Sermelyan/RFIDreader/README.md

# RFIDreader
Stm32+mfrc522
Ссылка на папку с документацией - https://drive.google.com/open?id=1Ol4aUnXzzG5ZaBnfFhphDsJd5Xnp3BTj
