Sermelyan/RFIDreader/Documentation/Э1C.jpg

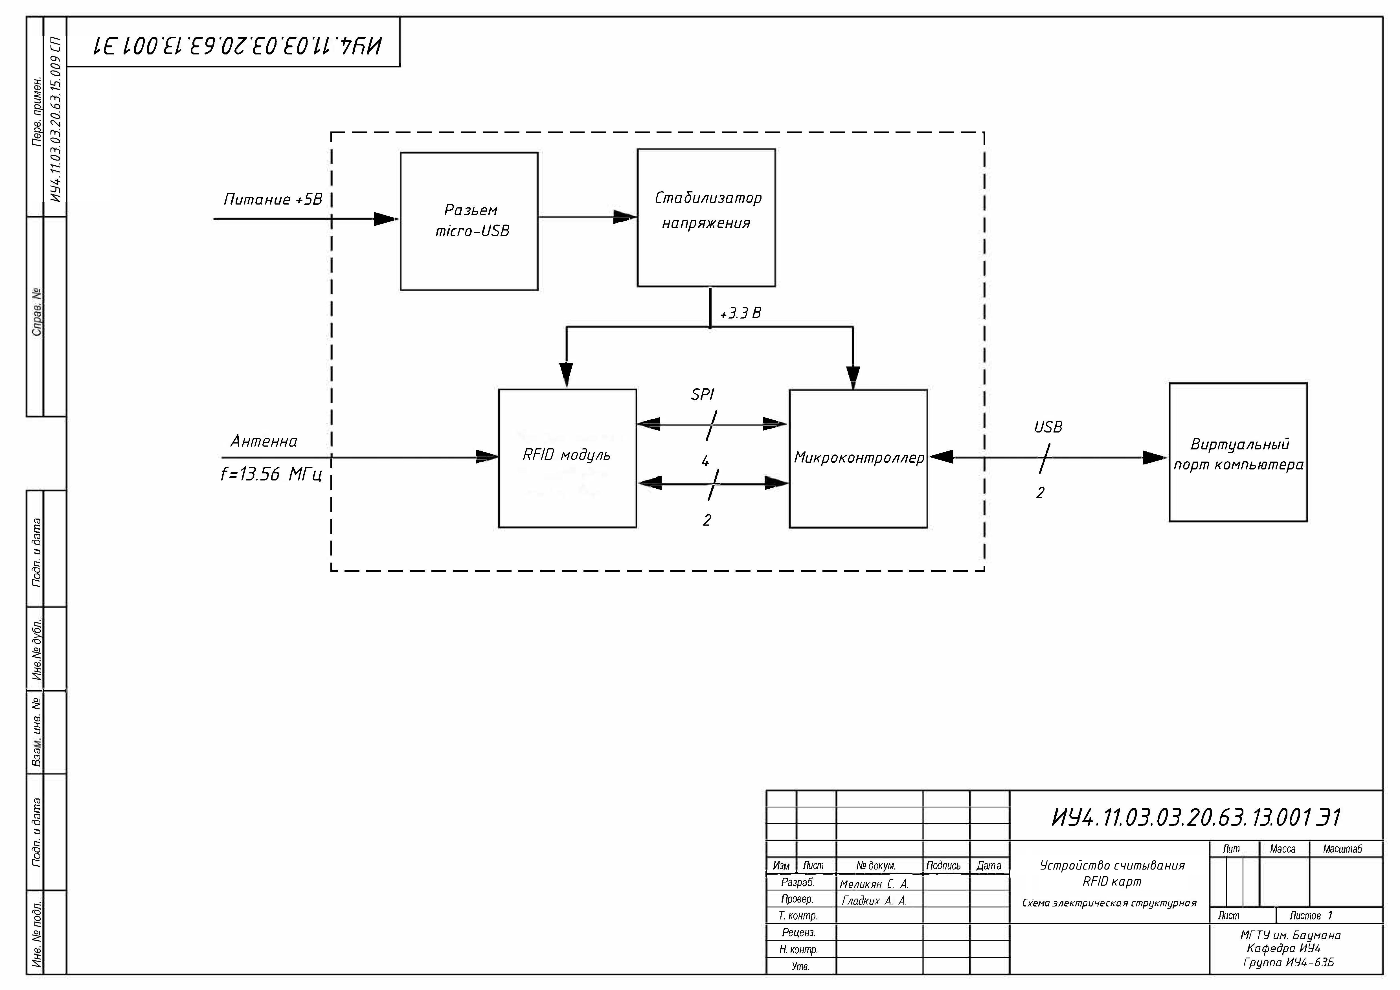
Documentation/Э1C.jpg
