Sermelyan/RFIDreader/(list of files, cad)

Other CAD files:
Hardware/3D/Board.iam
Hardware/3D/C1.iam
Hardware/3D/C10.iam
Hardware/3D/C11.iam
Hardware/3D/C12.iam
Hardware/3D/C2.iam
Hardware/3D/C3.iam
Hardware/3D/C4.iam
Hardware/3D/C5.iam
Hardware/3D/C6.iam
Hardware/3D/C7.iam
Hardware/3D/C8.iam
Hardware/3D/C9.iam
Hardware/3D/D1.iam
Hardware/3D/DA1.iam
Hardware/3D/Open CASCADE STEP translator 6.8 1.1.1.ipt
Hardware/3D/PLS-1.iam
Hardware/3D/PLS-1_1.iam
Hardware/3D/PLS-4.iam
Hardware/3D/PLS-8.iam
Hardware/3D/R1.iam
Hardware/3D/R2.iam
Hardware/3D/R3.iam
Hardware/3D/R4.iam
Hardware/3D/R5.iam
Hardware/3D/R6.iam
Hardware/3D/R7.iam
Hardware/3D/R8.iam
Hardware/3D/R9.iam
Hardware/3D/SB1.iam
Hardware/3D/SOT-223.ipt
Hardware/3D/STM32F334.ipt
Hardware/3D/SW3dPS-0805_SMD_Capacitor.ipt
Hardware/3D/User_Library-AVX_D_CASE.ipt
Hardware/3D/User_Library-CapAluRadial_D80H115.iam
Hardware/3D/User_Library-CapAluRadial_D80H115_can.ipt
Hardware/3D/User_Library-CapAluRadial_D80H115_lead.ipt
Hardware/3D/User_Library-CapAluRadial_D80H115_rubber_pad.ipt
Hardware/3D/User_Library-CapAluRadial_D80H115_shell_and_minus.ipt
Hardware/3D/User_Library-CapAluRadial_D80H115_shell_and_minus_2.ipt
Hardware/3D/User_Library-Diode_Molded_BodyDIOM5025X231N.ipt
Hardware/3D/User_Library-FYLS-1206.ipt
Hardware/3D/User_Library-PTS645SL43SMTR92-LFS.iam
Hardware/3D/User_Library-PTS645SL43SMTR92-LFS_1.ipt
Hardware/3D/User_Library-PTS645SL43SMTR92-LFS_10.ipt
Hardware/3D/User_Library-PTS645SL43SMTR92-LFS_11.ipt
Hardware/3D/User_Library-PTS645SL43SMTR92-LFS_2.ipt
Hardware/3D/User_Library-PTS645SL43SMTR92-LFS_3.ipt
Hardware/3D/User_Library-PTS645SL43SMTR92-LFS_4.ipt
Hardware/3D/User_Library-PTS645SL43SMTR92-LFS_5.ipt
Hardware/3D/User_Library-PTS645SL43SMTR92-LFS_6.ipt
Hardware/3D/User_Library-PTS645SL43SMTR92-LFS_7.ipt
Hardware/3D/User_Library-PTS645SL43SMTR92-LFS_8.ipt
Hardware/3D/User_Library-PTS645SL43SMTR92-LFS_9.ipt
Hardware/3D/User_Library-SMU4.iam
Hardware/3D/User_Library-SMU4_SM4_BASE_2_Valor_predeterminado.ipt
Hardware/3D/User_Library-SMU4_SMU4_BASE_Valor_predeterminado.ipt
Hardware/3D/User_Library-micro_usb_SMD.ipt
Hardware/3D/VD1.iam
Hardware/3D/VD2.iam
Hardware/3D/VD3.iam
Hardware/3D/VD3.newVer.iam
Hardware/3D/X1.iam
Hardware/3D/X2.iam
Hardware/3D/X3.iam
Hardware/3D/ZQ1.iam
Hardware/3D/chip_0805_r.ipt
Hardware/3D/îñíîâàíèå.ipt
Hardware/3D/îñíîâàíèå_1.ipt
Hardware/3D/ïðÿìîé_øòûðü.ipt
Hardware/3D/ïðÿìîé_øòûðü_1.ipt
Hardware/3D/ИУ4.11.03.03.20.63.13.iam
