Sermelyan/RFIDreader/Documentation/ИУ4.11.03.03.20.63.13.003 Э3.pdf

2 DA1

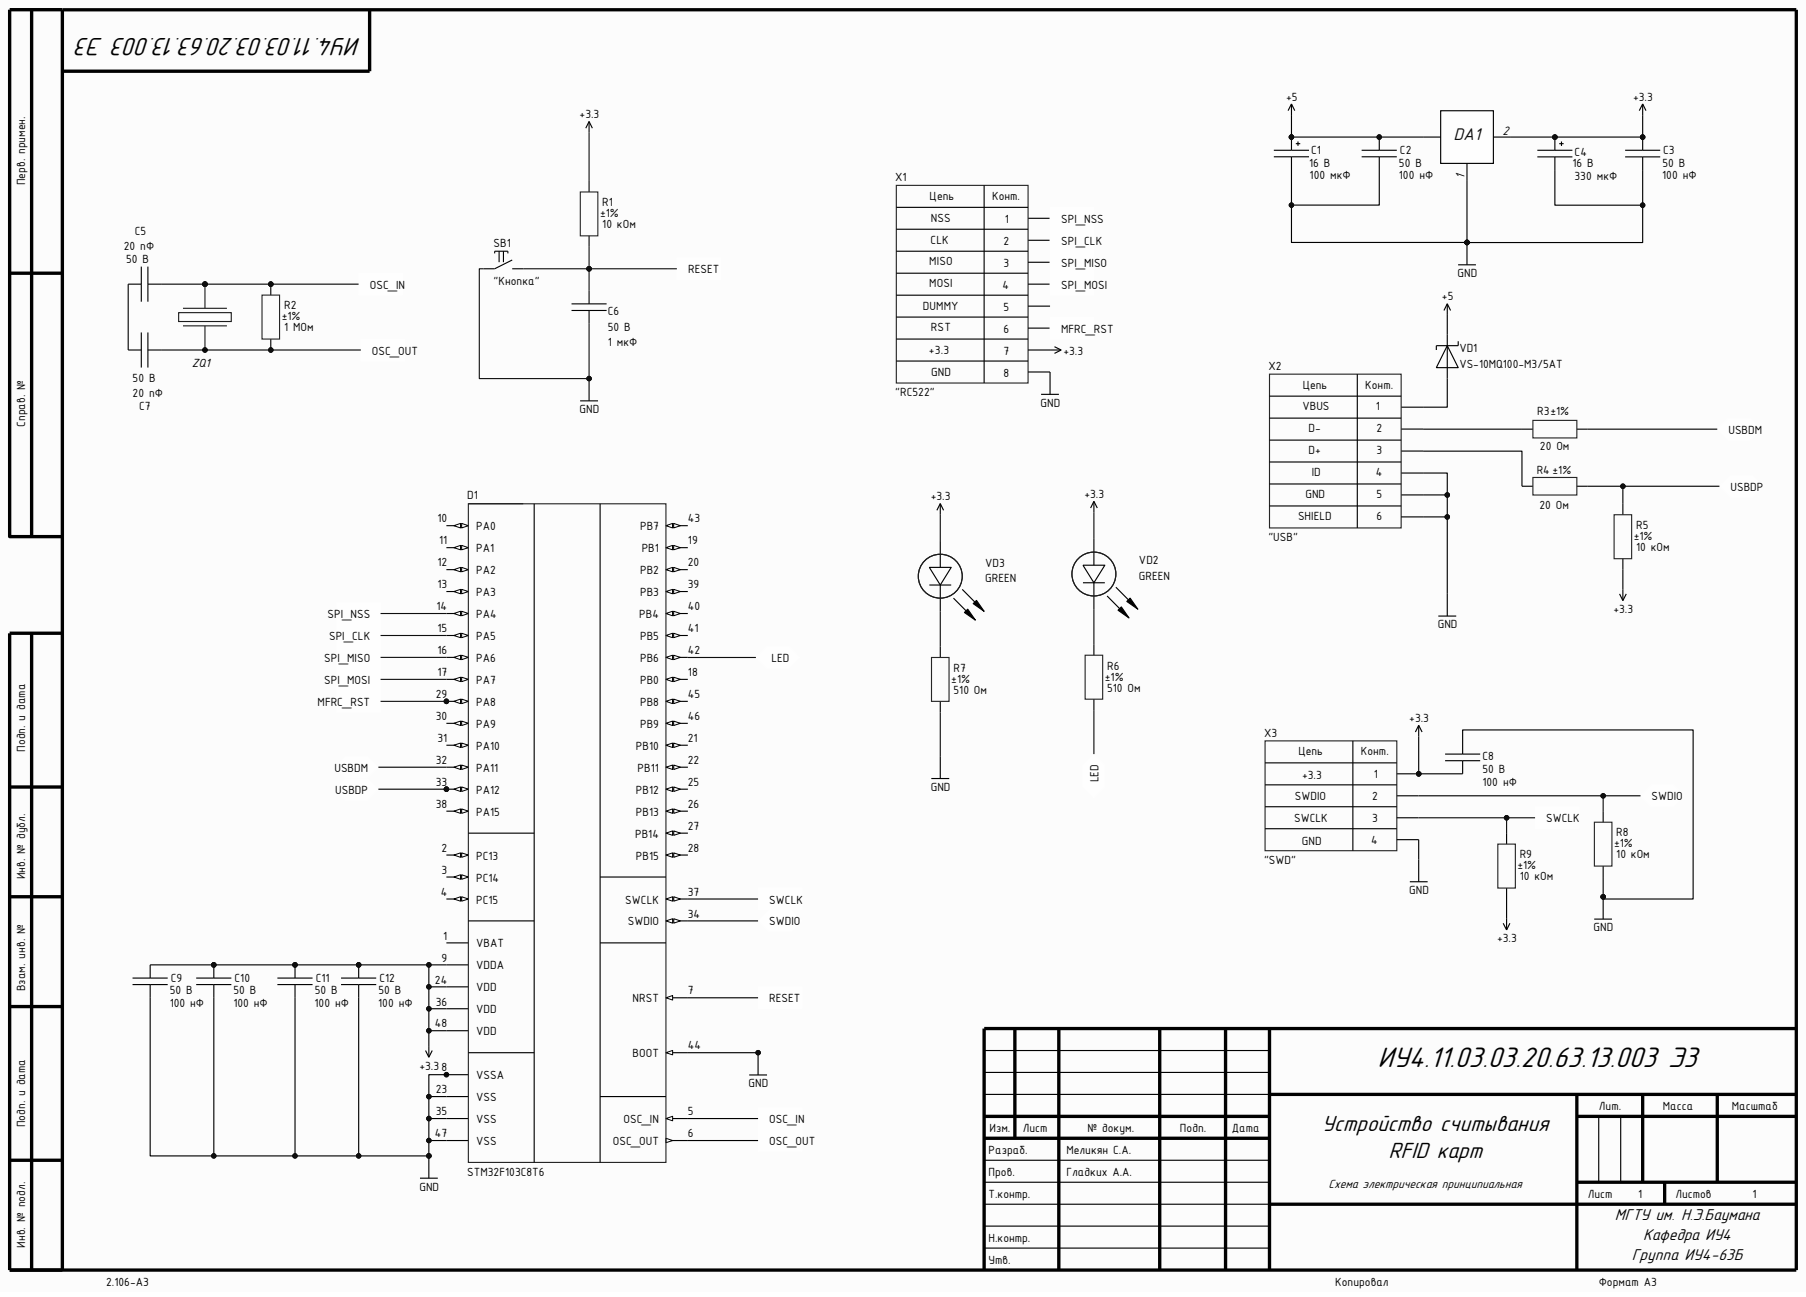
[picture p26: page 1]

Инв. № подл. Инв. № дубл. Подп. и дата Взам. инв. № Подп. и дата Перв. примен. Справ. №

Цепь | Конт.
NSS | 1

CLK | 2

MISO | 3

MOSI | 4

DUMMY | 5

RST | 6

GND | 8

VBUS | 1

D- | 2
D+ | 3 | 20 Ом R4 ±1%

GND | 5

SHIELD | 6

SWDIO | 2

SWCLK | 3

GND | 4

Изм. | Лист | № докум. | Подп. | Дата

Разраб. | | Меликян С.А.

Пров. | | Гладких А.А.

Т.контр. | | | | | Лист 1 | Листов 1

z £ xª£¤ «§  Ãðóïïà ÈÓ4-63Á

Н.контр.

Утв.
