Sermelyan/RFIDreader/Documentation/ИУ4.11.03.03.20.63.13.002 ПД1.pdf

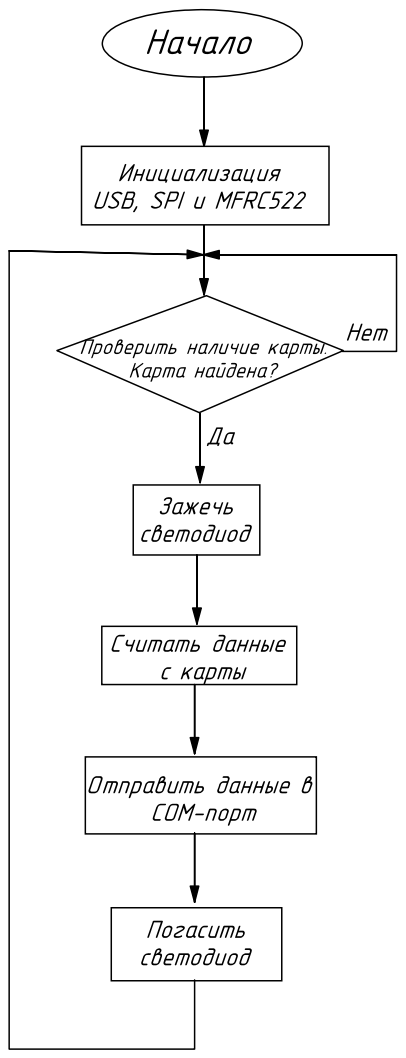
[picture p27: page 1]
