Sermelyan/RFIDreader/Documentation/ИУ4.11.03.03.20.63.13.004 ПЭЗ.pdf

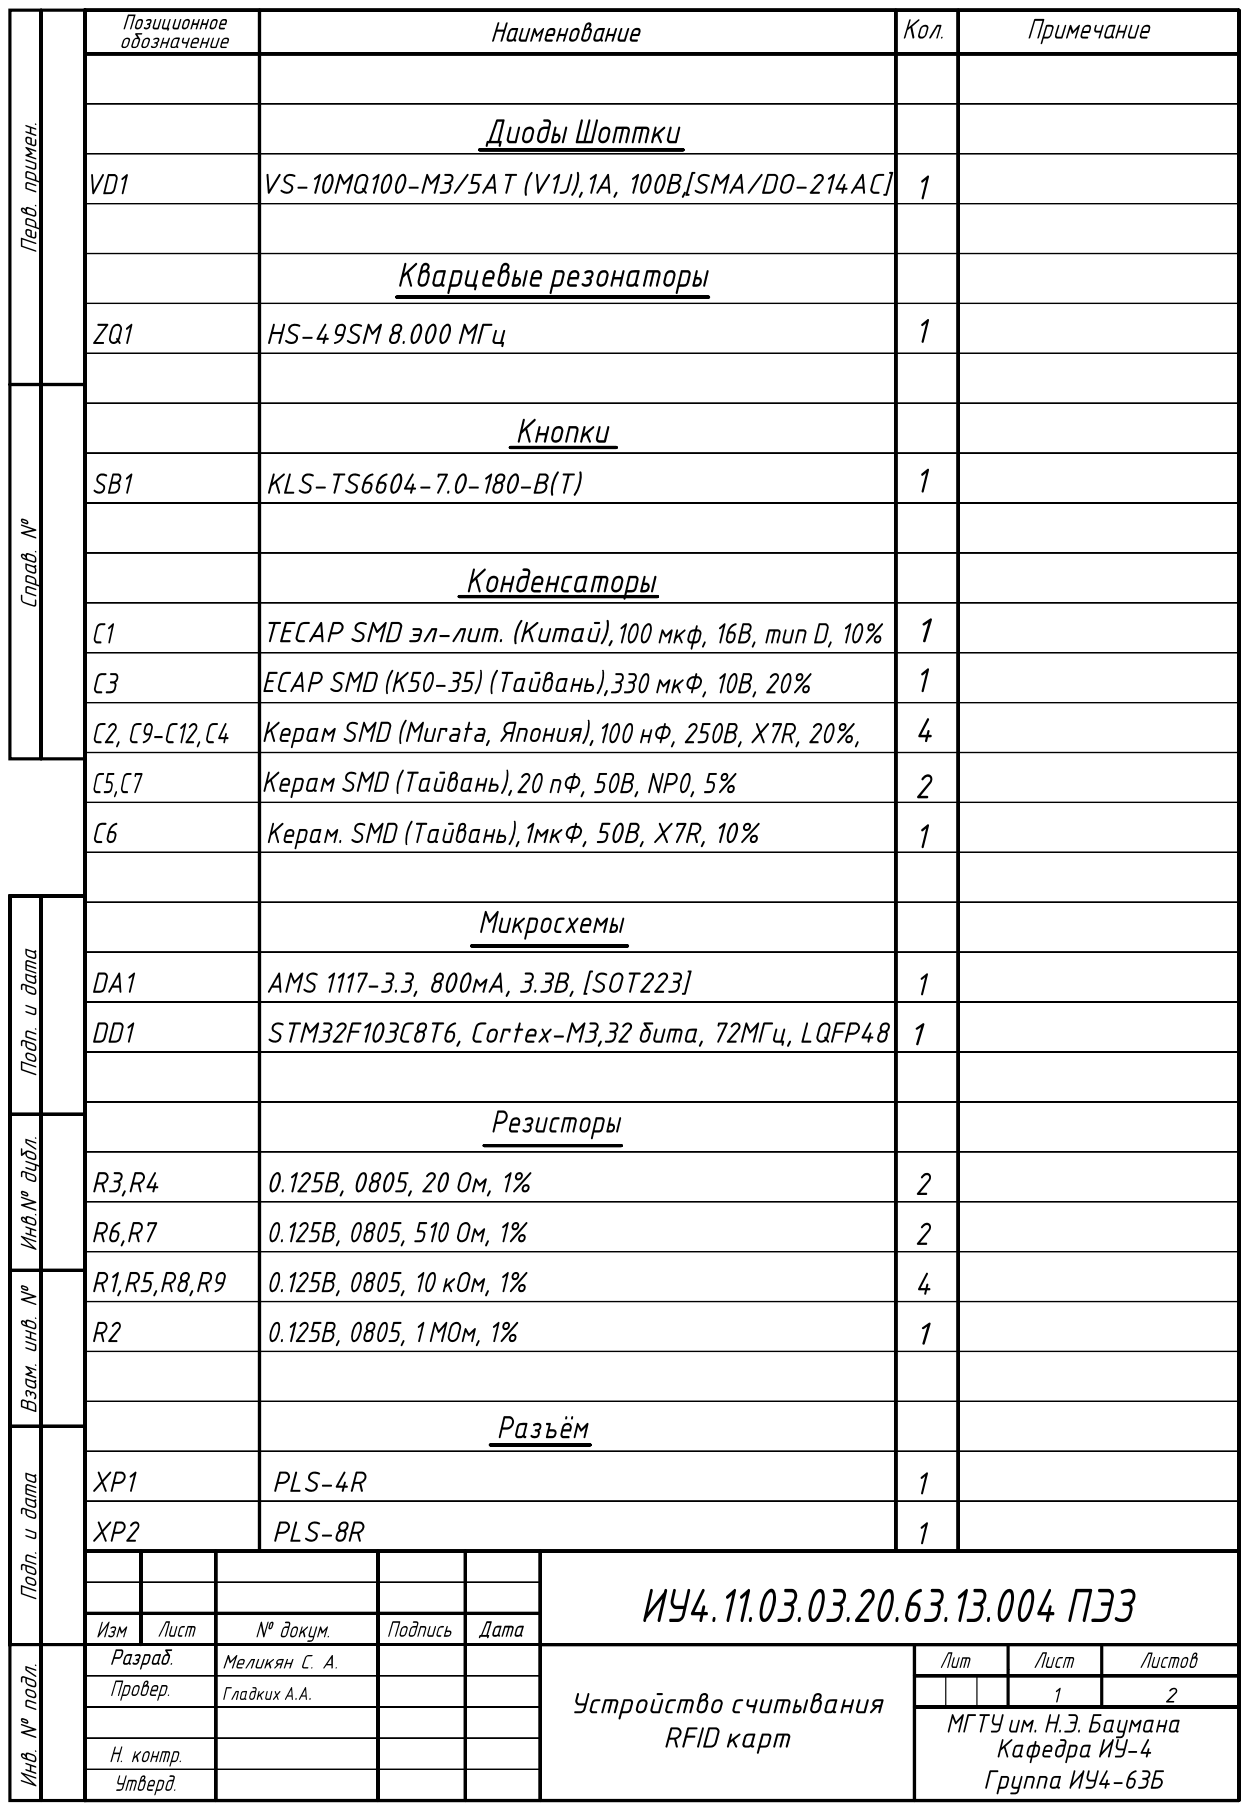
[picture p28: page 1]

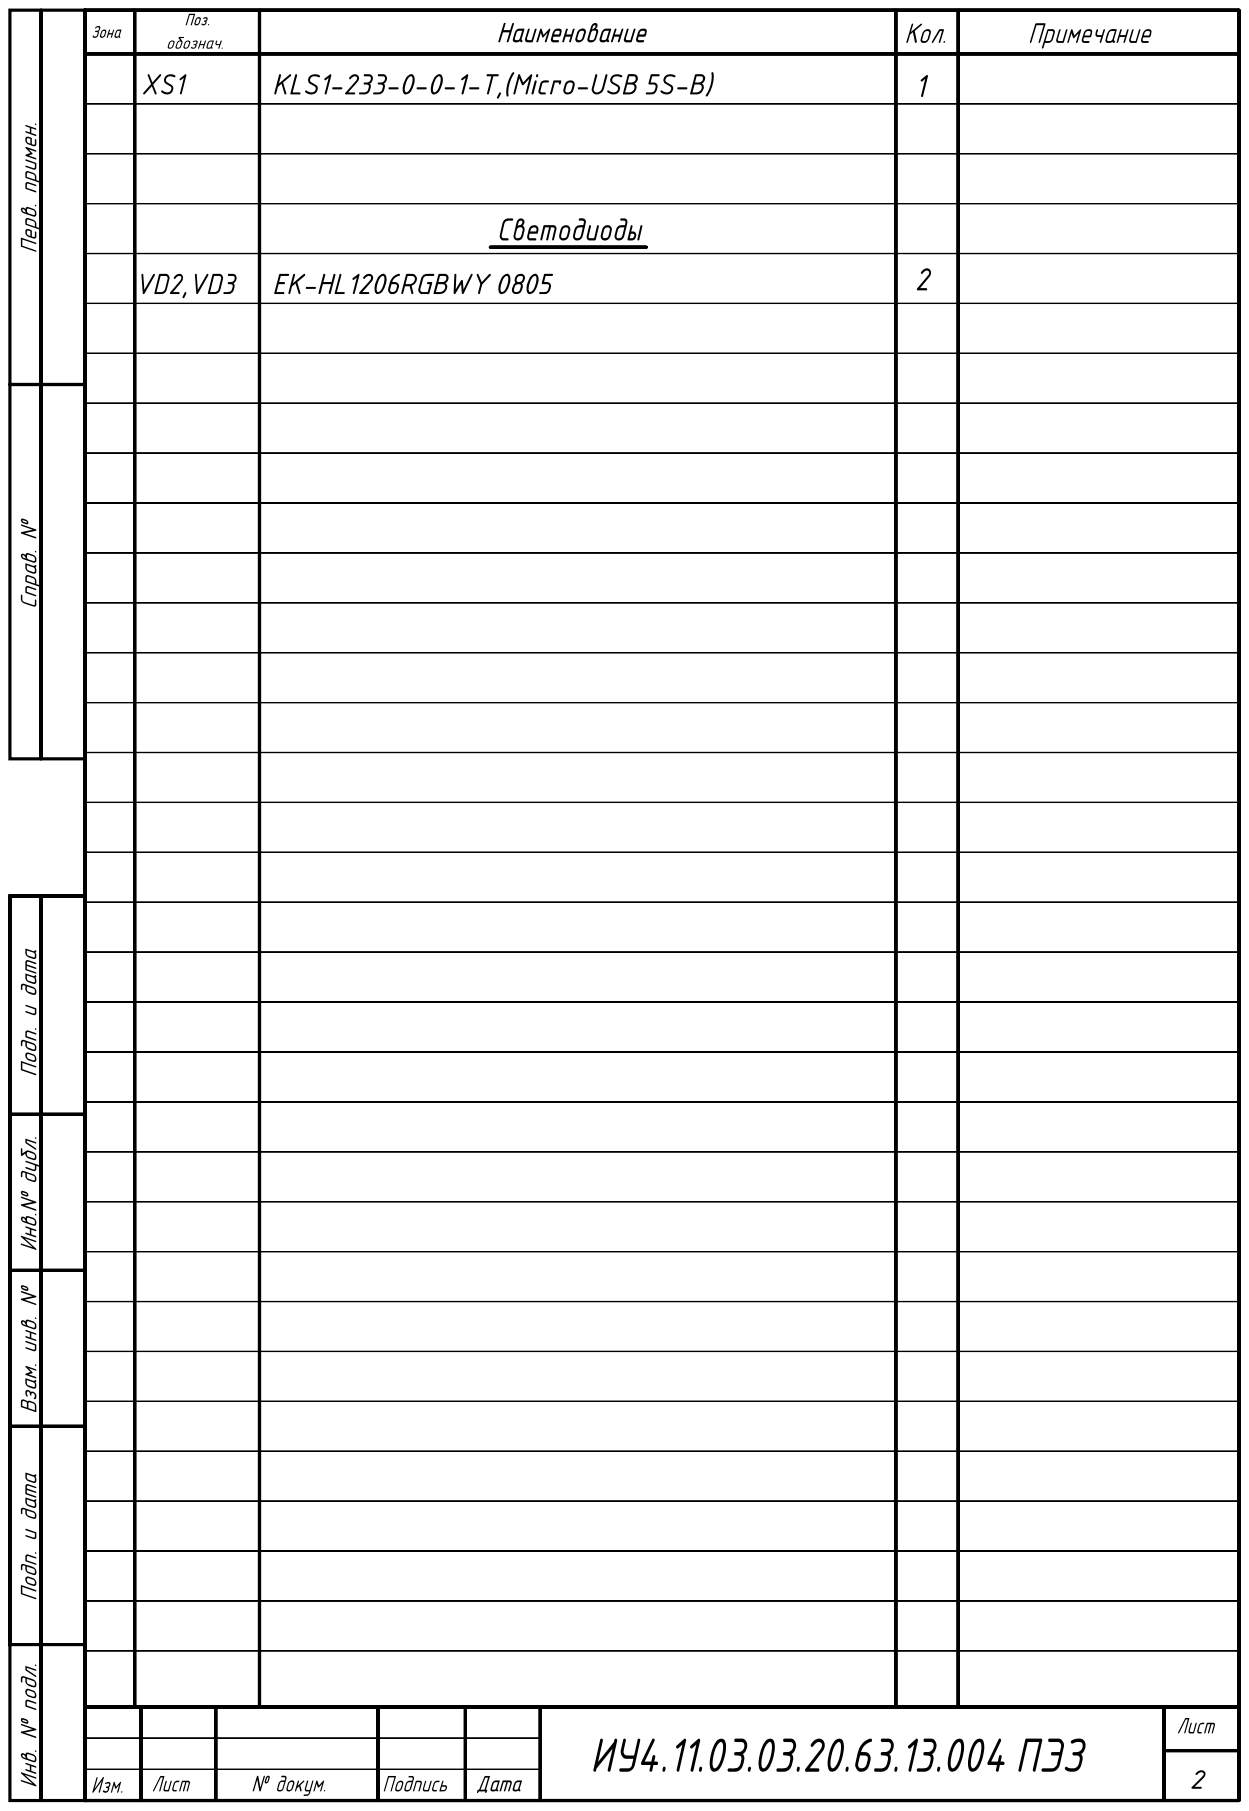
[picture p29: page 2]
