Sermelyan/RFIDreader/Documentation/ИУ4.11.03.03.20.63.13.007 Э1.pdf

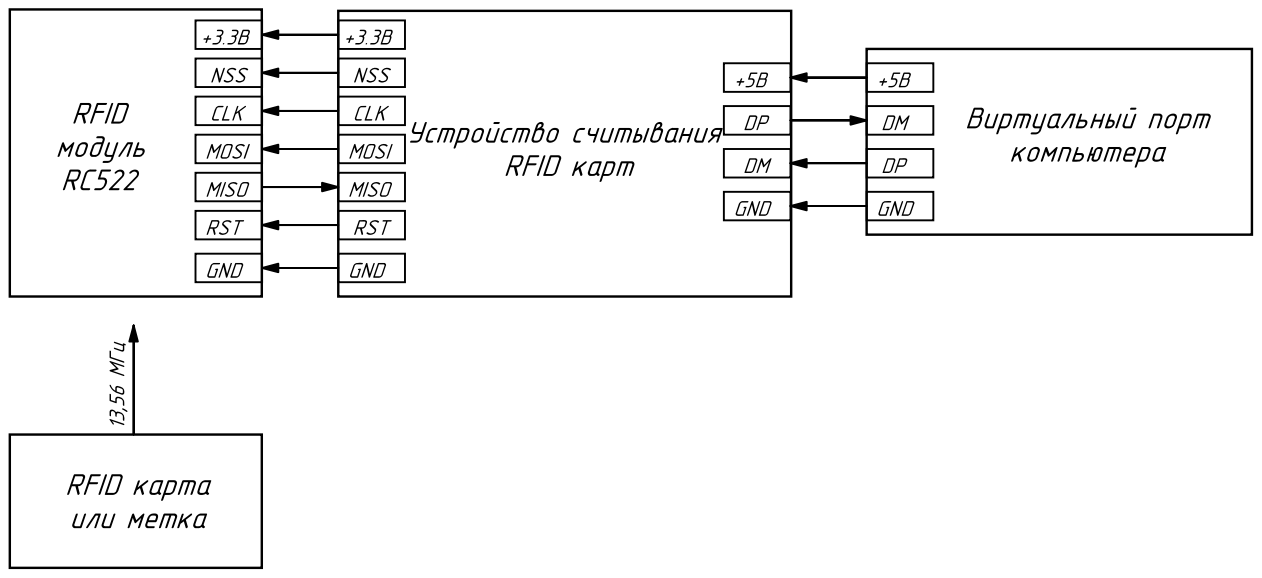
[picture p30: page 1]
