Sermelyan/RFIDreader/Documentation/ИУ4.11.03.03.20.63.13.009 СП1.pdf

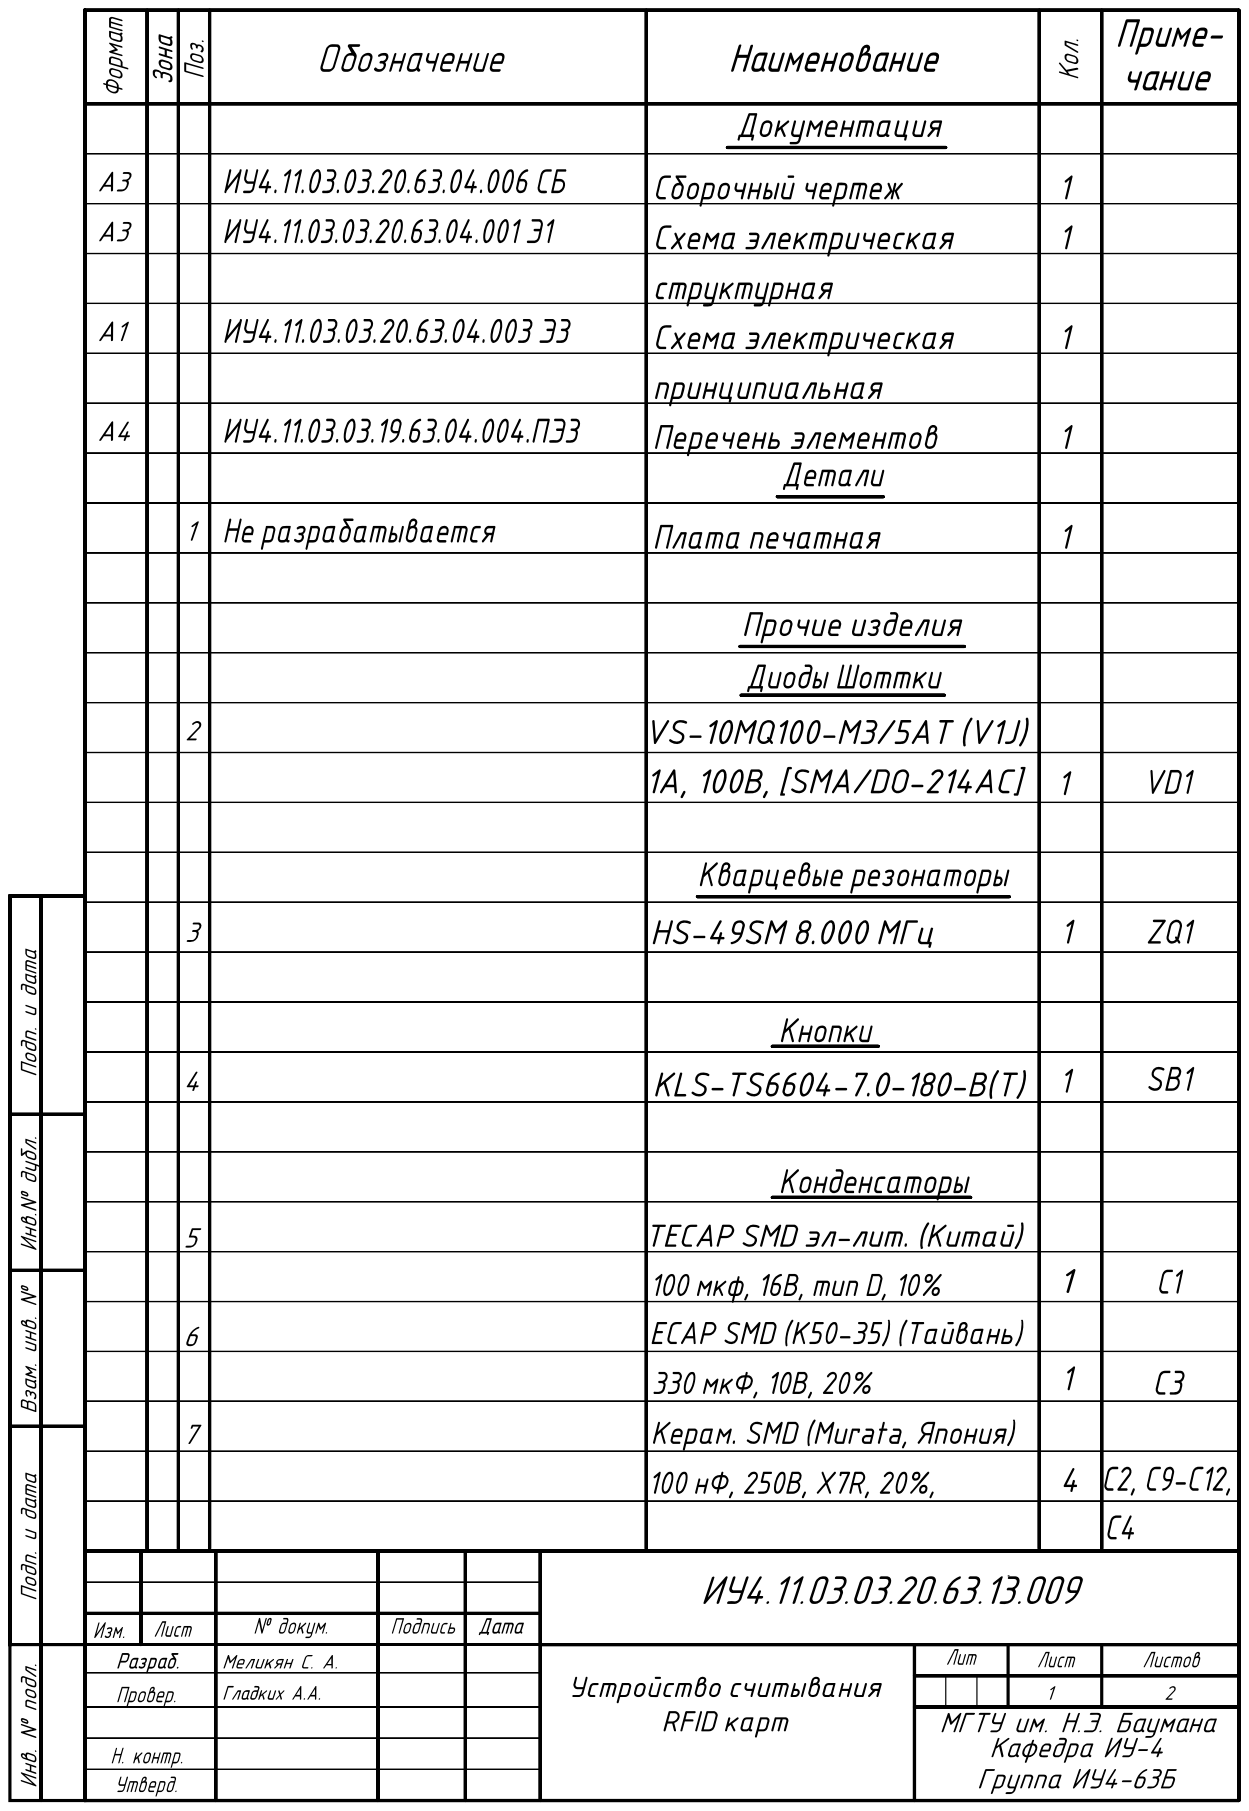
[picture p31: page 1]
