Sermelyan/RFIDreader/Documentation/ИУ4.11.03.03.20.63.13.009 СП2.pdf

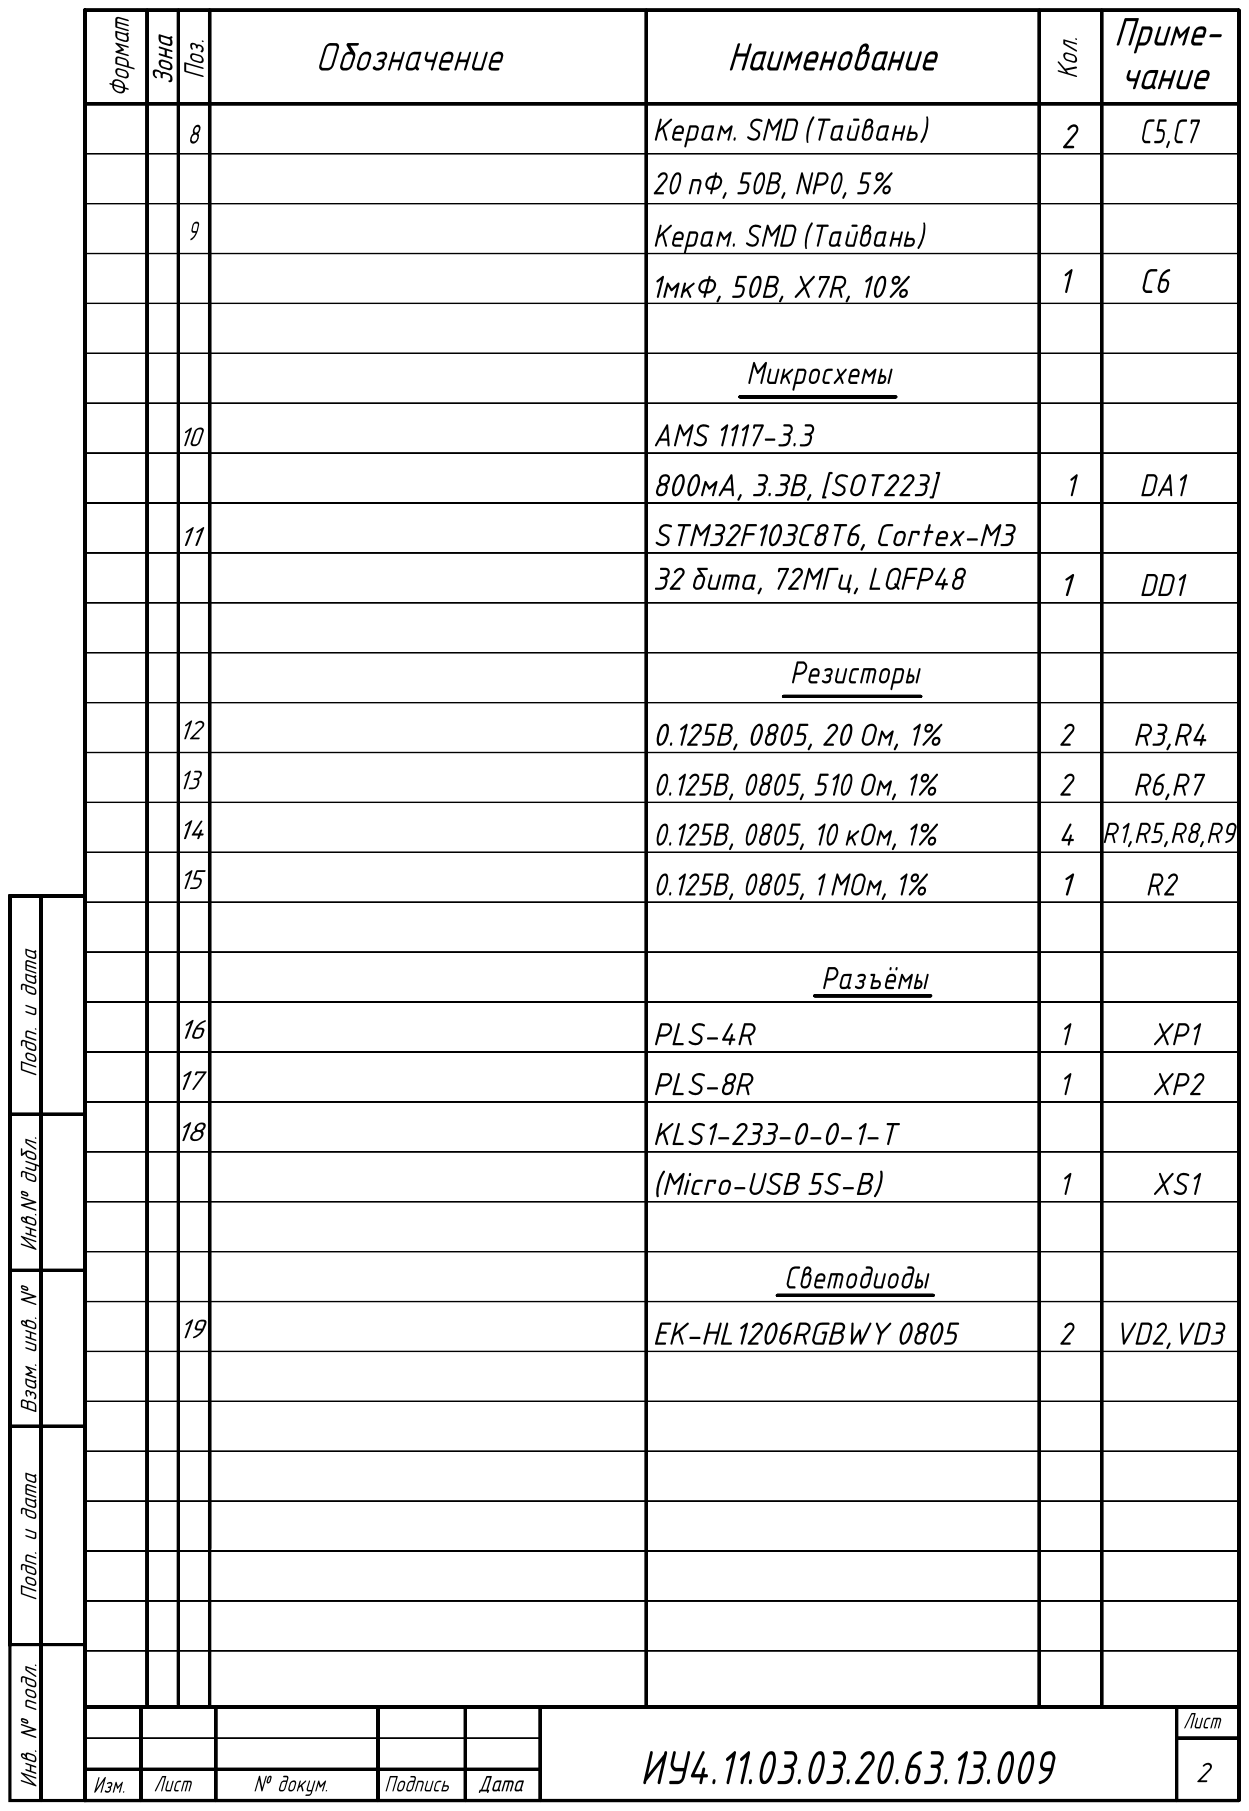
[picture p32: page 1]
