Sermelyan/RFIDreader/(list of files, drawings)

Other design files:
Hardware/ИУ4.11.03.03.20.63.13.PcbDoc
Hardware/ИУ4.11.03.03.20.63.13.PrjPcb
Hardware/ИУ4.11.03.03.20.63.13.SchDoc
