Sermelyan/RFIDreader/Software/Core/Src/main.c

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
/* Includes ------------------------------------------------------------------*/
#include "main.h"
#include "usb_device.h"

/* USER CODE BEGIN Includes */

#include "rc522.h"
#include "usbd_cdc_if.h"

/* USER CODE END Includes */

SPI_HandleTypeDef hspi1;

void SystemClock_Config(void);
static void MX_GPIO_Init(void);
static void MX_SPI1_Init(void);
/* USER CODE BEGIN 0 */
uint8_t blockAddr;
uint8_t RC_size;

uint8_t sectorKeyA[16][16] = {{0xFF, 0xFF, 0xFF, 0xFF, 0xFF, 0xFF},
                              {0xFF, 0xFF, 0xFF, 0xFF, 0xFF, 0xFF},
                              {0xFF, 0xFF, 0xFF, 0xFF, 0xFF, 0xFF},
                              {0xFF, 0xFF, 0xFF, 0xFF, 0xFF, 0xFF},};

uint8_t status;
uint8_t	str[MFRC522_MAX_LEN];
uint8_t sn[4];
char	buff[64];
uint8_t i;
uint8_t size;
/* USER CODE END 0 */

/**
  * @brief  The application entry point.
  * @retval int
  */
int main(void)
{
  /* MCU Configuration--------------------------------------------------------*/

  /* Reset of all peripherals, Initializes the Flash interface and the Systick. */
  HAL_Init();

  /* Configure the system clock */
  SystemClock_Config();

  /* Initialize all configured peripherals */
  MX_GPIO_Init();
  MX_SPI1_Init();
  MX_USB_DEVICE_Init();
  /* USER CODE BEGIN 2 */
  MFRC522_Init();
  /* USER CODE END 2 */

  /* Infinite loop */
  /* USER CODE BEGIN WHILE */
  while (1)
  {
//      MFRC522_Init();
      size = sprintf(buff, "\033[H\033[2J");
      CDC_Transmit_FS(buff, size);

      HAL_Delay(20);

      status = MI_ERR;

      // Look for the card, return type
      status = MFRC522_Request(PICC_REQIDL, str);
      if (status == MI_OK) {
          size = sprintf(buff, "SAK: 0x%02X, 0x%02X\n", str[1], str[0]);
          CDC_Transmit_FS(buff, size);
          HAL_GPIO_TogglePin(GPIOB, GPIO_PIN_6);
      }
      else {
          size = sprintf(buff, "SAK: ----  ----\n");
          CDC_Transmit_FS(buff, size);
      }

      // Anti-collision, return the card's 4-byte serial number
      status = MFRC522_Anticoll(sn);
      if (status == MI_OK) {
          size = sprintf(buff, "CN: %x%x%x%x\n", sn[0],sn[1],sn[2],sn[3]);
          CDC_Transmit_FS(buff, size);
      }
      else {
          size = sprintf(buff, "CN: --------\n");
          CDC_Transmit_FS(buff, size);
      }

      // Election card, return capacity
      RC_size = MFRC522_SelectTag(sn);
      if (RC_size != 0) {
          size = sprintf(buff, "CS: %d\n", RC_size);
          CDC_Transmit_FS(buff, size);
      }
      else {
          size = sprintf(buff, "CS: -\n");
          CDC_Transmit_FS(buff, size);
      }

      // Card reader
      status = MFRC522_Auth(PICC_AUTHENT1A, 11, sectorKeyA[2], sn);
      if (status == MI_OK) {
          // Read data
          status = MFRC522_Read(11, str);
          if (status == MI_OK) {
              size = sprintf(buff, "%02X %02X %02X %02X %02X %02X %02X %02X\n", str[0],str[1],str[2],str[3],str[4],str[5],str[6],str[7]);
              CDC_Transmit_FS(buff, size);
              size = sprintf(buff, "%02X %02X %02X %02X %02X %02X %02X %02X\n", str[8],str[9],str[10],str[11],str[12],str[13],str[14],str[15]);
              CDC_Transmit_FS(buff, size);
          }
          HAL_GPIO_TogglePin(GPIOB, GPIO_PIN_14);
      }
      else {
          size = sprintf(buff, "-- -- -- -- -- -- -- --\n");
          CDC_Transmit_FS(buff, size);
      }

      HAL_Delay(2);

      MFRC522_Halt();
      HAL_Delay(200);
//      MFRC522_AntennaOff();
    /* USER CODE END WHILE */

    /* USER CODE BEGIN 3 */
  }
  /* USER CODE END 3 */
}

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
