Sermelyan/RFIDreader/(commit log)

2020-05-02 altium added
    [ИУ4.11.03.03.20.63.13.PrjPcb, ИУ4.11.03.03.20.63.13.SchDoc]
2020-05-03 base hardware
    [ИУ4.11.03.03.20.63.13.PcbDoc, ИУ4.11.03.03.20.63.13.PrjPcb, ИУ4.11.03.03.20.63.13.SchDoc]
2020-05-05 info and changes
    [ИУ4.11.03.03.20.63.13.PcbDoc, ИУ4.11.03.03.20.63.13.SchDoc]
2020-09-06 разводка закончена
    [ИУ4.11.03.03.20.63.13.GBL, ИУ4.11.03.03.20.63.13.GBO, ИУ4.11.03.03.20.63.13.GBP, ИУ4.11.03.03.20.63.13.GBS, ИУ4.11.03.03.20.63.13.GKO, ИУ4.11.03.03.20.63.13.GTL, ИУ4.11.03.03.20.63.13.GTO, ИУ4.11.03.03.20.63.13.GTP]
2020-09-07 board shape added
    [ИУ4.11.03.03.20.63.13.PcbDoc, ИУ4.11.03.03.20.63.13.PrjPcb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]
2020-09-08 prerelease hardware
    [ИУ4.11.03.03.20.63.13.PcbDoc, ИУ4.11.03.03.20.63.13.SchDoc]
2020-09-08 hardware finished
    [ИУ4.11.03.03.20.63.13.GBL, ИУ4.11.03.03.20.63.13.GBO, ИУ4.11.03.03.20.63.13.GBP, ИУ4.11.03.03.20.63.13.GBS, ИУ4.11.03.03.20.63.13.GM1, ИУ4.11.03.03.20.63.13.GTL, ИУ4.11.03.03.20.63.13.GTO, ИУ4.11.03.03.20.63.13.GTP]
2020-09-30 soft init
    [stm32bp103cc.cfg]
